krishecejee1008-creator/esp32-s3-mpu6050-board/docs/pcb-3d-bottom.png

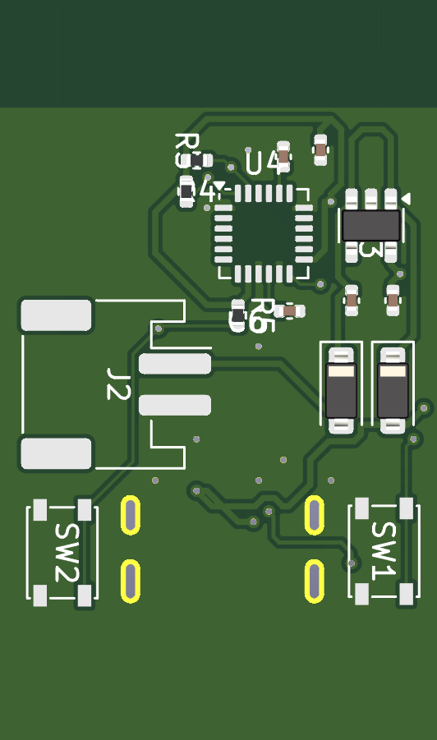
docs/pcb-3d-bottom.png
