krishecejee1008-creator/esp32-s3-mpu6050-board/docs/ESP32C3_MPU6050_Board.csv

Reference | Qty | Value | DNP | Exclude from BOM | Exclude from Board | Footprint | Datasheet
C1,C2,C3 | 3 | 10uF |  |  |  | Capacitor_SMD:C_0402_1005Metric | ~
C4,C6,C8 | 3 | 100nF |  |  |  | Capacitor_SMD:C_0402_1005Metric | ~
C5 | 1 | 1uF |  |  |  | Capacitor_SMD:C_0402_1005Metric | ~
C7 | 1 | 2.2nF |  |  |  | Capacitor_SMD:C_0402_1005Metric | ~
D1,D2 | 2 | D_Schottky |  |  |  | Diode_SMD:D_SOD-123 | ~
J1 | 1 | USB_C_Receptacle_USB2.0_16P |  |  |  | Connector_USB:USB_C_Receptacle_Amphenol_124019772112A | https://www.usb.org/sites/default/files/documents/usb_type-c.zip
J2 | 1 | Conn_01x02 |  |  |  | Connector_JST:JST_PH_S2B-PH-SM4-TB_1x02-1MP_P2.00mm_Horizontal | ~
R1,R2 | 2 | 5.1K |  |  |  | Resistor_SMD:R_0402_1005Metric | ~
R3,R4 | 2 | 4.7K |  |  |  | Resistor_SMD:R_0402_1005Metric | ~
R5 | 1 | 10K |  |  |  | Resistor_SMD:R_0402_1005Metric | ~
SW1,SW2 | 2 | SW_Push |  |  |  | Button_Switch_SMD:SW_SPST_PTS810 | ~
U1 | 1 | ESP32-S3-MINI-1 |  |  |  | RF_Module:ESP32-S2-MINI-1 | https://www.espressif.com/sites/default/files/documentation/esp32-s3-mini-1_mini-1u_datasheet_en.pdf
U2 | 1 | USBLC6-2SC6 |  |  |  | Package_TO_SOT_SMD:SOT-23-6 | https://www.st.com/resource/en/datasheet/usblc6-2.pdf
U3 | 1 | AP2112K-3.3 |  |  |  | Package_TO_SOT_SMD:SOT-23-5 | https://www.diodes.com/assets/Datasheets/AP2112.pdf
U4 | 1 | MPU-6050 |  |  |  | Sensor_Motion:InvenSense_QFN-24_4x4mm_P0.5mm | https://invensense.tdk.com/wp-content/uploads/2015/02/MPU-6000-Datasheet1.pdf
