krishecejee1008-creator/esp32-s3-mpu6050-board/docs/schematic.pdf

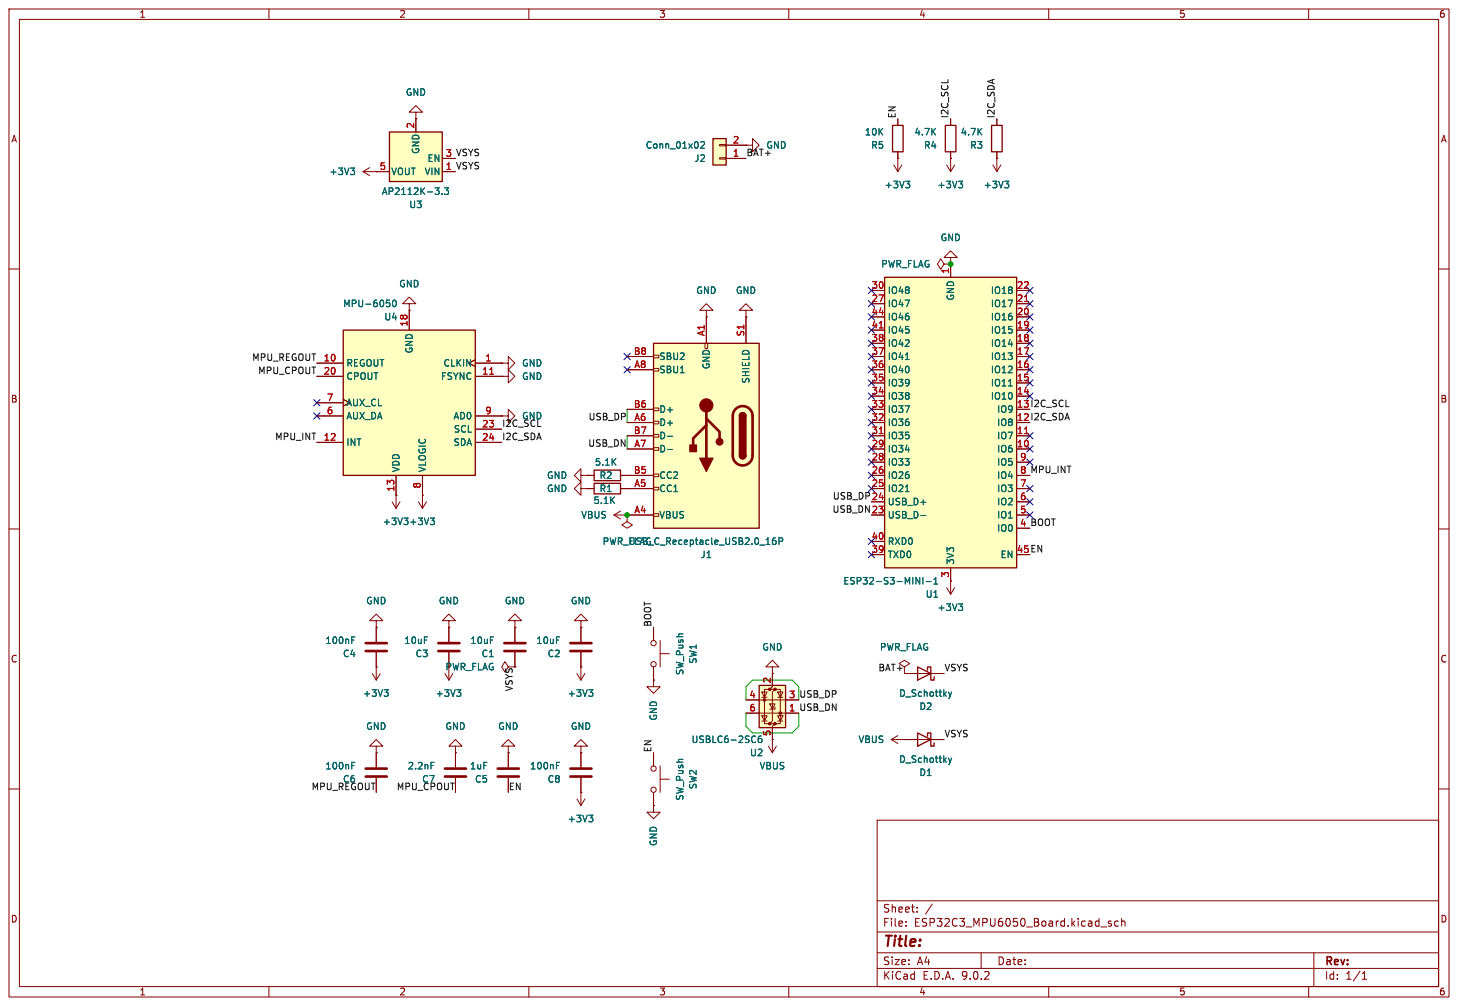
[picture p4: page 1]

IO48 30 GND GND GND GND
