krishecejee1008-creator/esp32-s3-mpu6050-board/docs/ESP32C3_MPU6050_Board-F_Cu.pdf

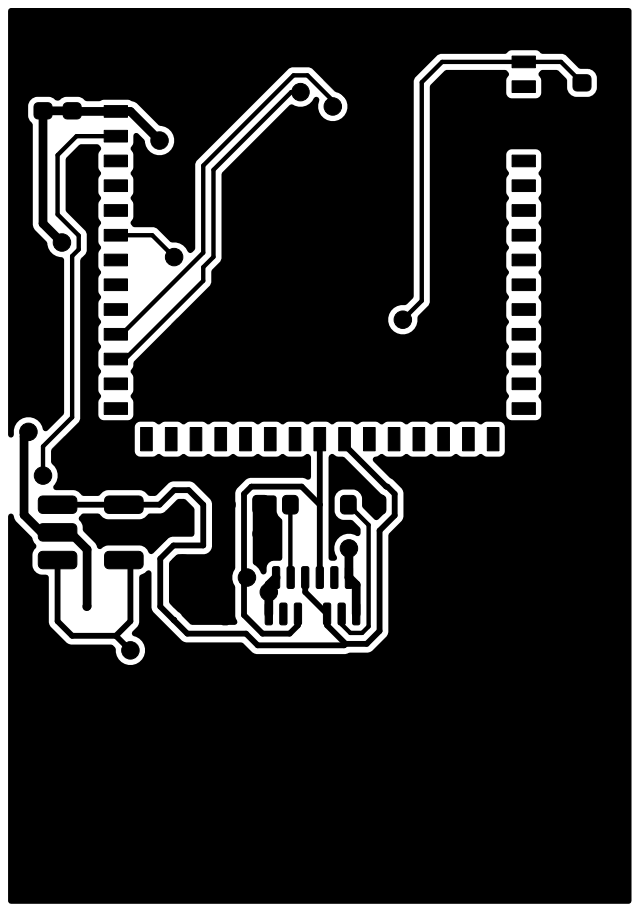
[picture p9: page 1]
