krishecejee1008-creator/esp32-s3-mpu6050-board/(commit log)

2026-11-07 Initial commit: ESP32-S3 + MPU-6050 board
    [ESP32C3_MPU6050_Board-B_Cu.gbr, ESP32C3_MPU6050_Board-B_Mask.gbr, ESP32C3_MPU6050_Board-B_Paste.gbr, ESP32C3_MPU6050_Board-B_Silkscreen.gbr, ESP32C3_MPU6050_Board-Edge_Cuts.gbr, ESP32C3_MPU6050_Board-F_Cu.gbr, ESP32C3_MPU6050_Board-F_Mask.gbr, ESP32C3_MPU6050_Board-F_Paste.gbr]
2026-11-07 Update Gerber files and zip
    [ESP32C3_MPU6050_Board-B_Cu.gbr, ESP32C3_MPU6050_Board-B_Mask.gbr, ESP32C3_MPU6050_Board-B_Paste.gbr, ESP32C3_MPU6050_Board-B_Silkscreen.gbr, ESP32C3_MPU6050_Board-Edge_Cuts.gbr, ESP32C3_MPU6050_Board-F_Cu.gbr, ESP32C3_MPU6050_Board-F_Mask.gbr, ESP32C3_MPU6050_Board-F_Paste.gbr]
